naman-tanwar/Automatic-Water-Tank-System/CKT.png

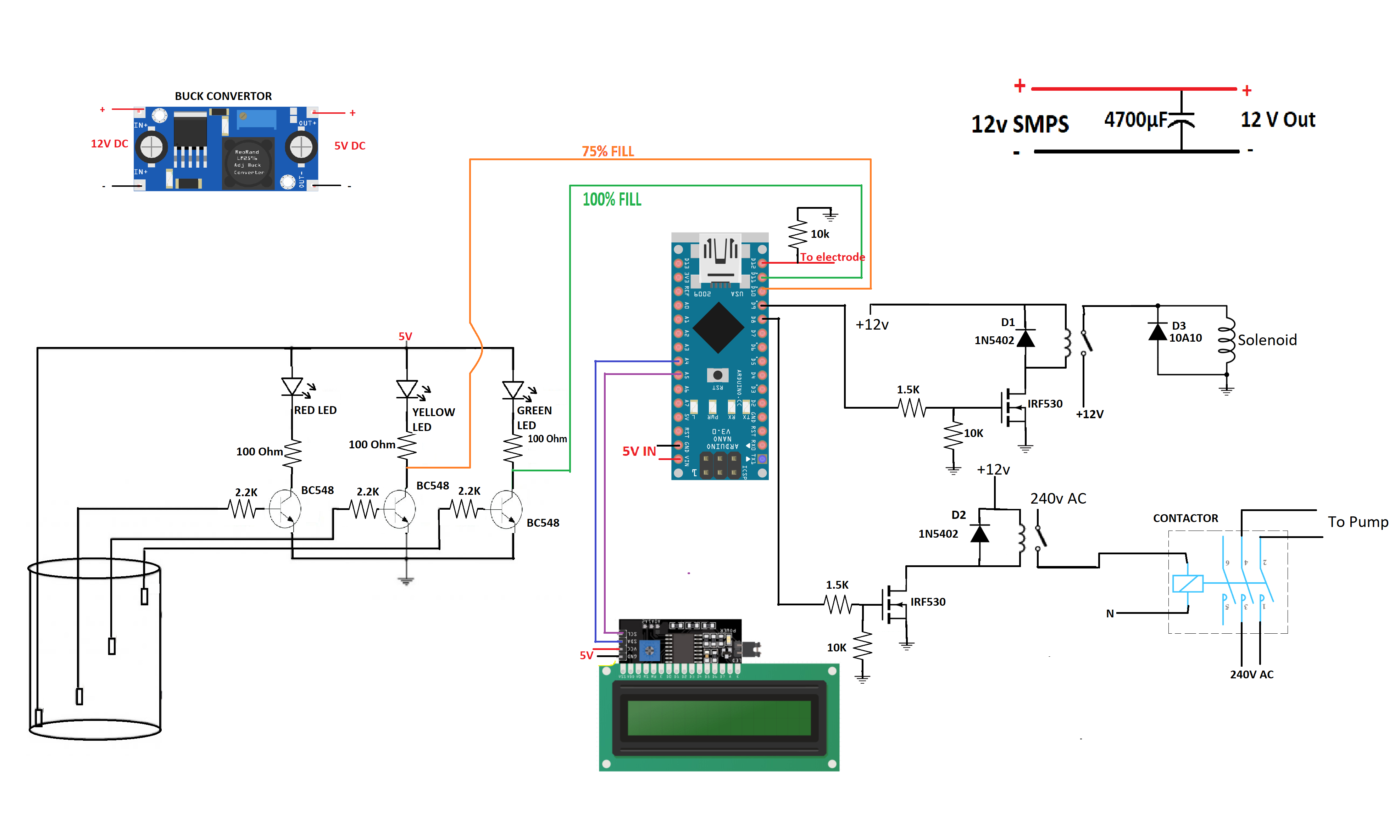
CKT.png
