naman-tanwar/Automatic-Water-Tank-System/Photos/IMG_20211016_184731.jpg

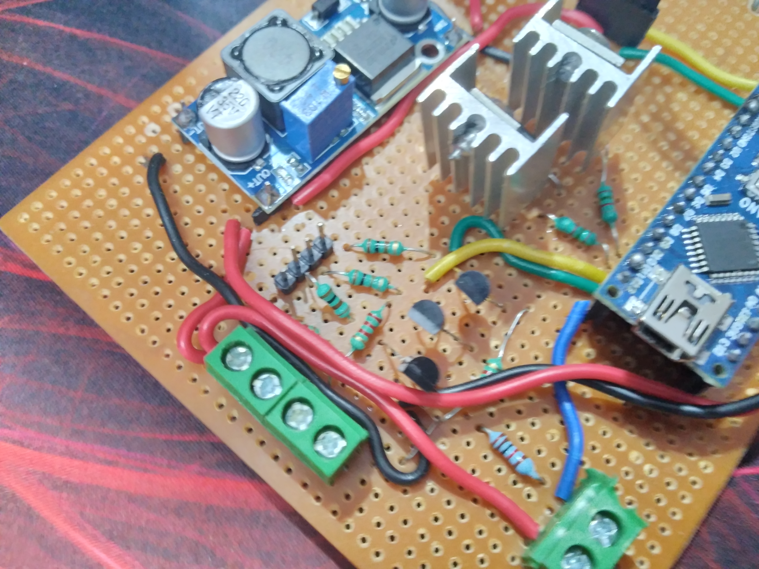
Photos/IMG_20211016_184731.jpg
