naman-tanwar/Automatic-Water-Tank-System/Photos/IMG_20211025_170004.jpg

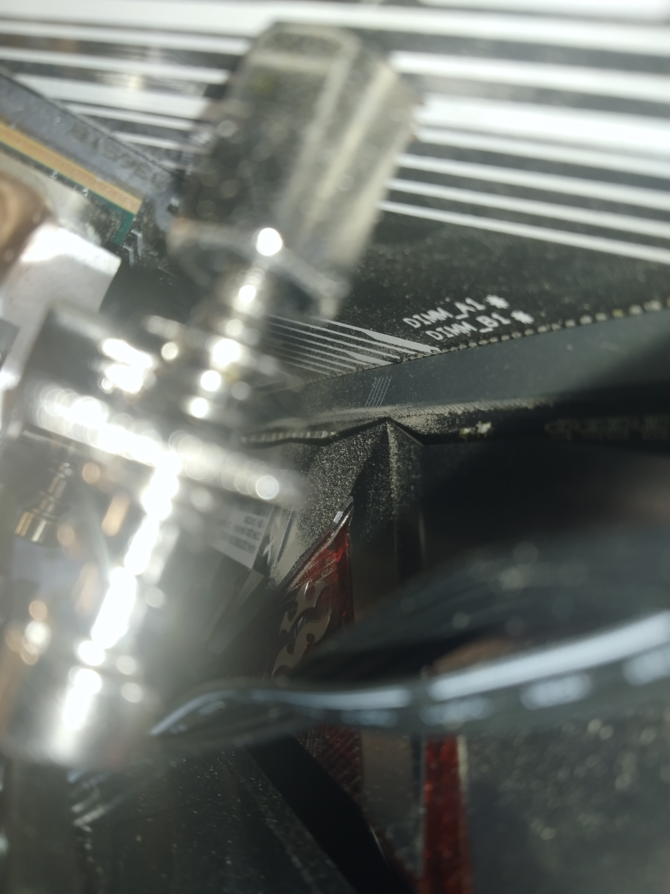
Photos/IMG_20211025_170004.jpg
