naman-tanwar/Automatic-Water-Tank-System/Photos/IMG_20211031_174219.jpg

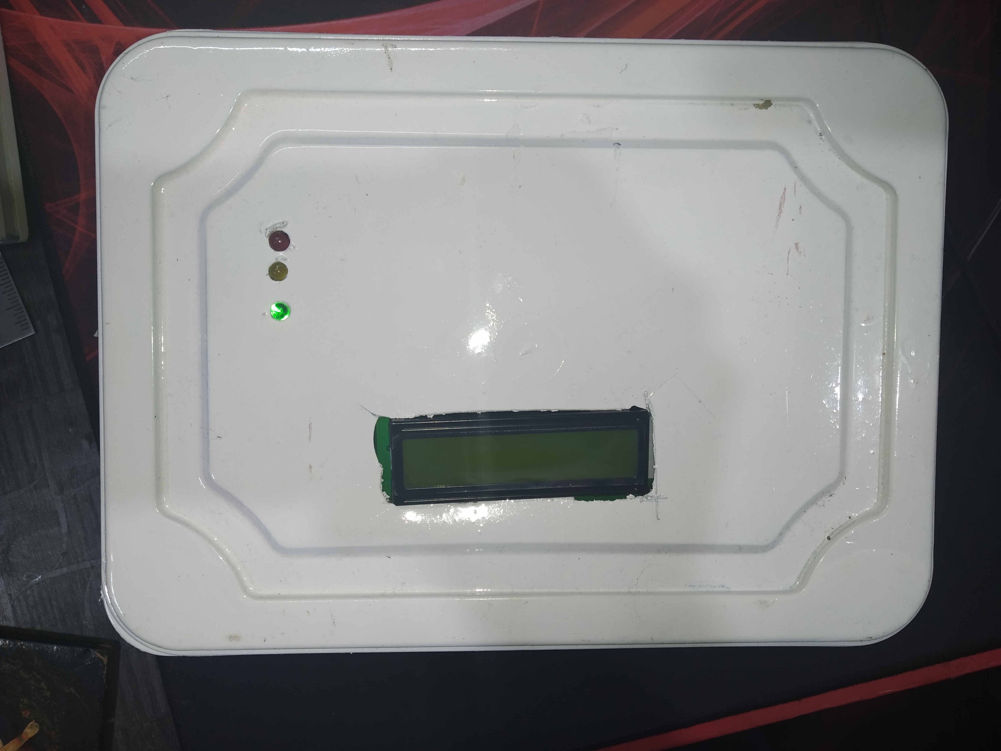
Photos/IMG_20211031_174219.jpg
