naman-tanwar/Automatic-Water-Tank-System/Photos/IMG_20211031_174246.jpg

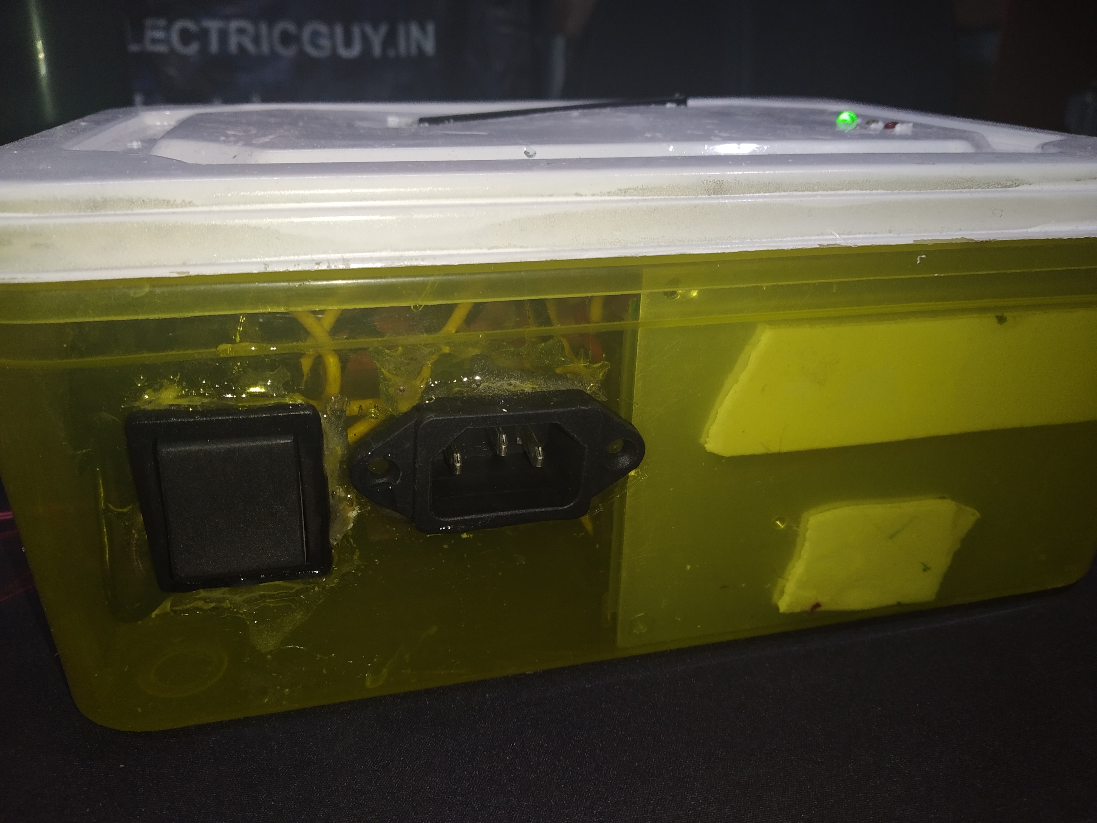
Photos/IMG_20211031_174246.jpg
