naman-tanwar/Automatic-Water-Tank-System/Photos/IMG_20211101_153914.jpg

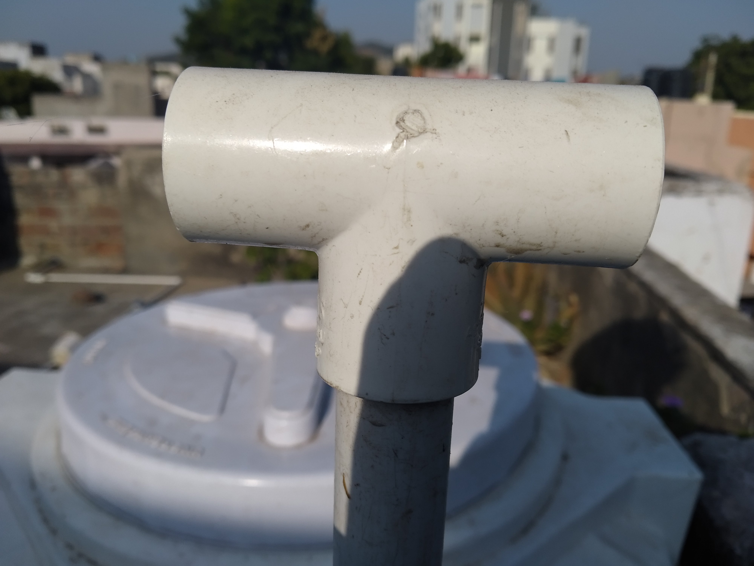
Photos/IMG_20211101_153914.jpg
