naman-tanwar/Automatic-Water-Tank-System/Photos/IMG_20211101_154036.jpg

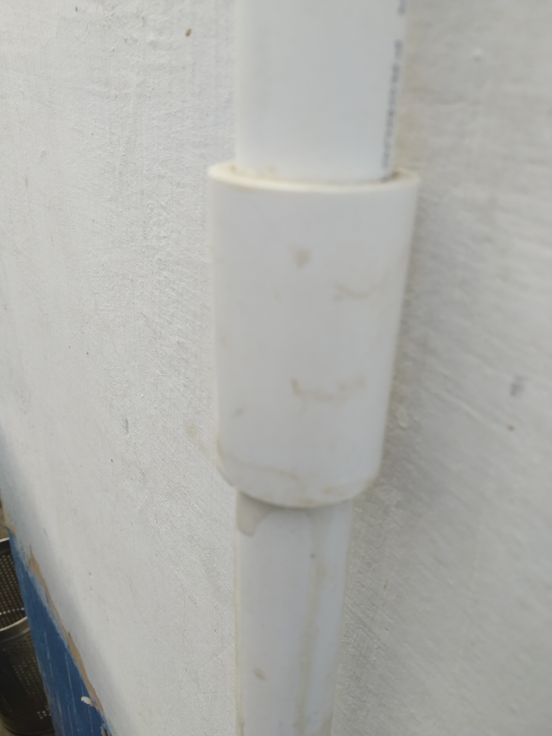
Photos/IMG_20211101_154036.jpg
