naman-tanwar/Automatic-Water-Tank-System/Photos/IMG_20211104_152333.jpg

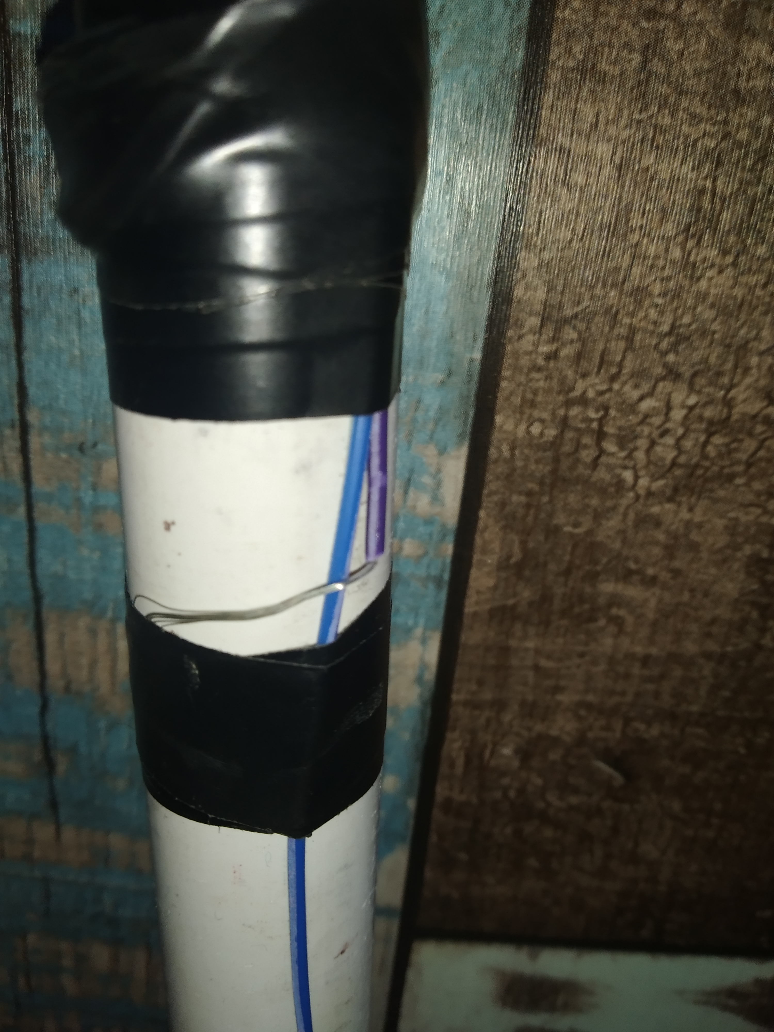
Photos/IMG_20211104_152333.jpg
