naman-tanwar/Automatic-Water-Tank-System/Photos/IMG_20211108_111341.jpg

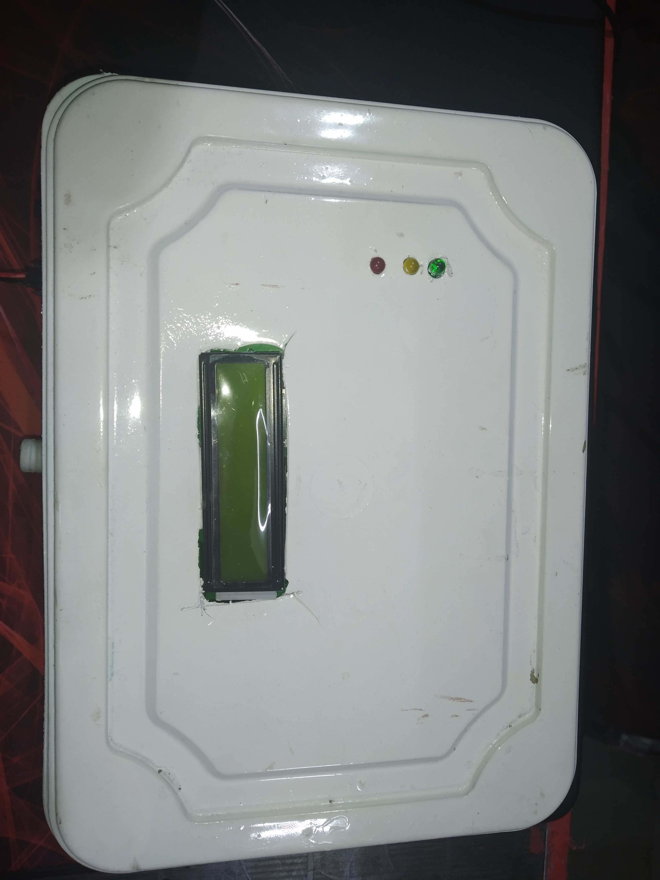
Photos/IMG_20211108_111341.jpg
